danheeks/BartonFirtop/bartonfirtop/Step Down Converter.stp

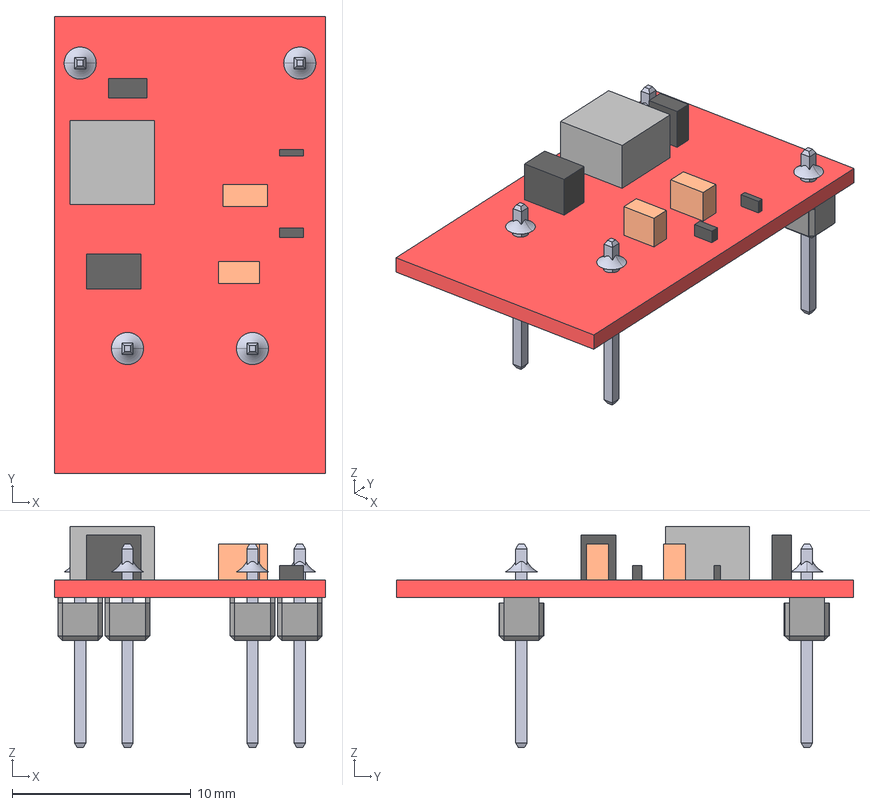
[picture p3: CAD file, 2025-02-03]
bartonfirtop/Step Down Converter.stp
15.2 x 25.6 x 12.4 mm
Design5
