danheeks/BartonFirtop/User Guide.docx

const char* ssid = "Paul's Phone";

const char* password = "Mani1234";

192.168.4.1
