danheeks/BartonFirtop/RD-077-03 _Rev.00.pdf

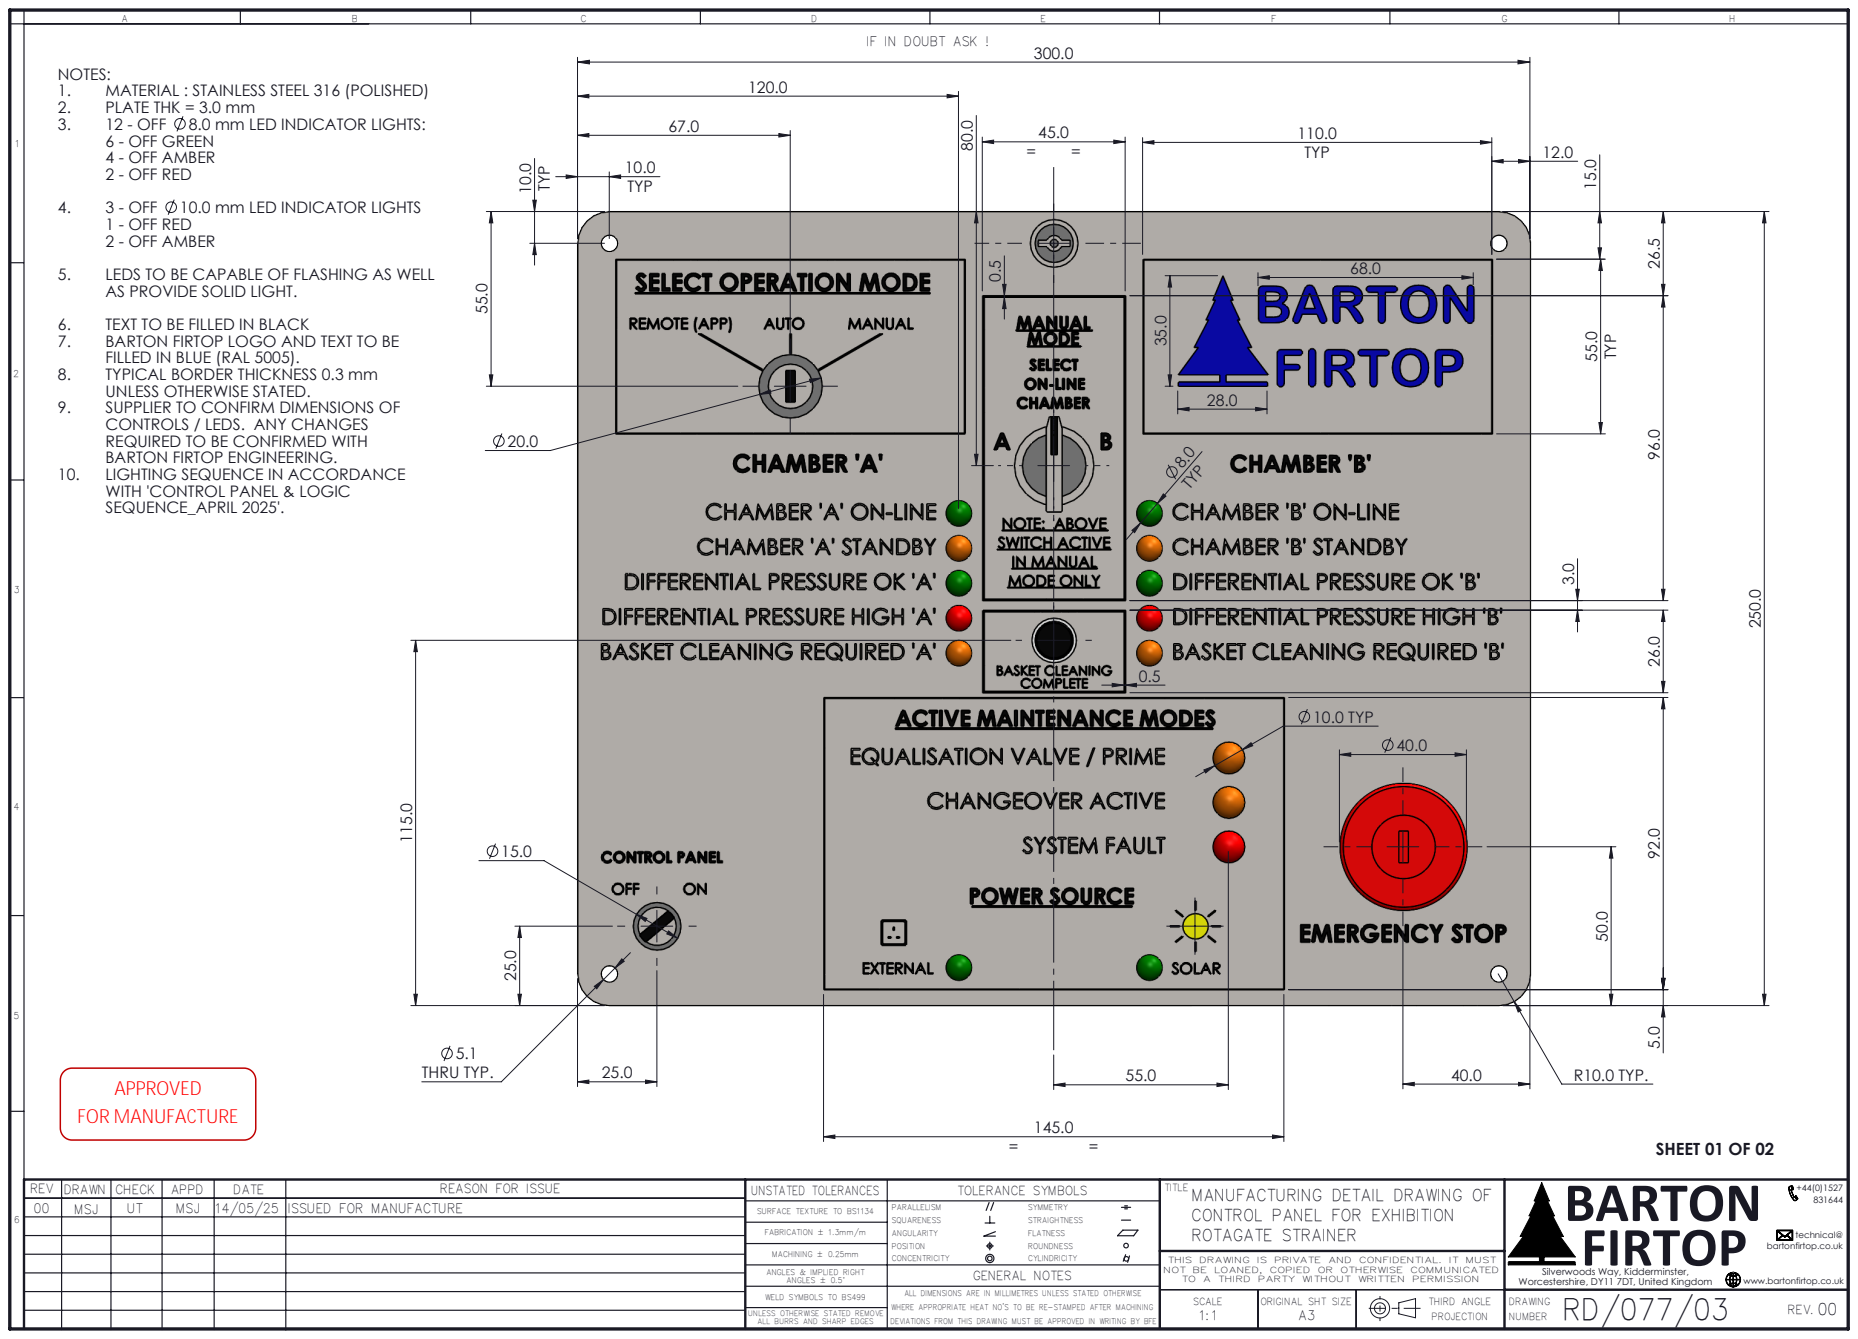
[picture p4: page 1]
Worcestershire, DY11 7DT, United Kingdom; www.bartonfirtop.co.uk; FIRTOP technical@; R10.0 TYP. 25.0; 10.0 TYP; THRU TYP.; SHEET 01 OF 02; REV DRAWN; DATE; SCALE; ORIGINAL SHT SIZE; THIRD ANGLE; TOLERANCE SYMBOLS; FABRICATION ± 1.3mm/m; UNSTATED TOLERANCES; ANGLES ± 0.5°; GENERAL NOTES; MSJ; MSJ 14/05/25

IF IN DOUBT ASK !

NOTES:
1. MATERIAL : STAINLESS STEEL 316 (POLISHED)
2. PLATE THK = 3.0 mm
3. 12 - OFF 8.0 mm LED INDICATOR LIGHTS:
6 - OFF GREEN
4 - OFF AMBER
2 - OFF RED
4. 3 - OFF 10.0 mm LED INDICATOR LIGHTS
1 - OFF RED
2 - OFF AMBER
5. LEDS TO BE CAPABLE OF FLASHING AS WELL
AS PROVIDE SOLID LIGHT.
6. TEXT TO BE FILLED IN BLACK
7. BARTON FIRTOP LOGO AND TEXT TO BE
FILLED IN BLUE (RAL 5005).
8. TYPICAL BORDER THICKNESS 0.3 mm
UNLESS OTHERWISE STATED.
9. SUPPLIER TO CONFIRM DIMENSIONS OF
CONTROLS / LEDS. ANY CHANGES
REQUIRED TO BE CONFIRMED WITH
BARTON FIRTOP ENGINEERING.
10. LIGHTING SEQUENCE IN ACCORDANCE
WITH 'CONTROL PANEL & LOGIC
SEQUENCE_APRIL 2025'.

REASON FOR ISSUE

TITLE
MANUFACTURING DETAIL DRAWING OF
CONTROL PANEL FOR EXHIBITION
ROTAGATE STRAINER

ISSUED FOR MANUFACTURE

SURFACE TEXTURE TO BS1134

bartonfirtop.co.uk

MACHINING ± 0.25mm
ANGLES & IMPLIED RIGHT

THIS DRAWING IS PRIVATE AND CONFIDENTIAL. IT MUST
NOT BE LOANED, COPIED OR OTHERWISE COMMUNICATED
TO A THIRD PARTY WITHOUT WRITTEN PERMISSION

Silverwoods Way, Kidderminster,

WELD SYMBOLS TO BS499
UNLESS OTHERWISE STATED REMOVE
ALL BURRS AND SHARP EDGES

ALL DIMENSIONS ARE IN MILLIMETRES UNLESS STATED OTHERWISE
WHERE APPROPRIATE HEAT NO'S TO BE RE-STAMPED AFTER MACHINING
DEVIATIONS FROM THIS DRAWING MUST BE APPROVED IN WRITING BY BFE

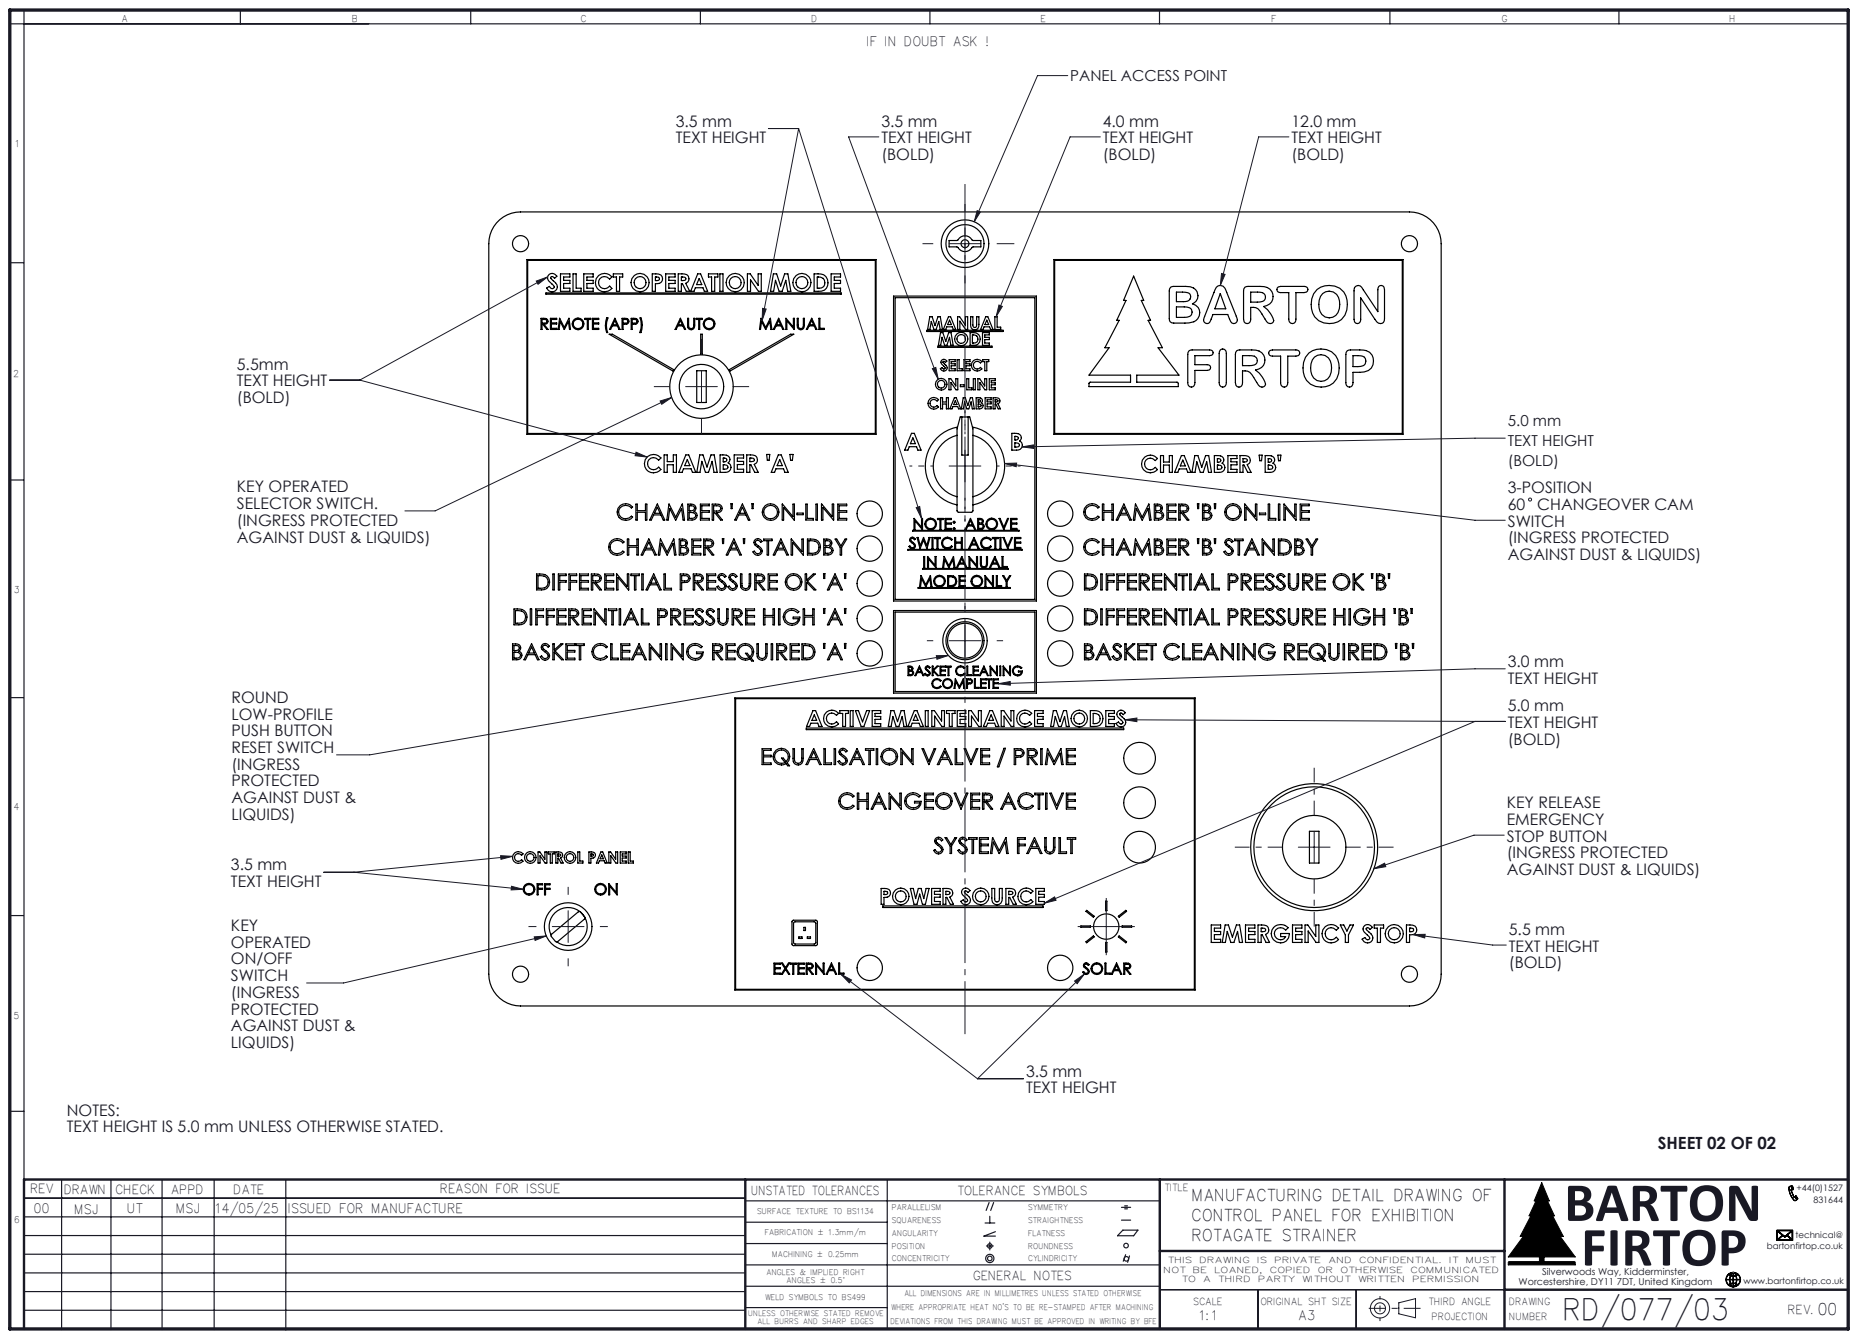
[picture p5: page 2]
Worcestershire, DY11 7DT, United Kingdom; www.bartonfirtop.co.uk; FIRTOP technical@; AGAINST DUST &; PUSH BUTTON RESET SWITCH; 3.5 mm TEXT HEIGHT; 5.5 mm TEXT HEIGHT; 12.0 mm TEXT HEIGHT; TEXT HEIGHT; 3.0 mm TEXT HEIGHT; 4.0 mm TEXT HEIGHT; 5.0 mm TEXT HEIGHT; SHEET 02 OF 02; REV DRAWN; DATE; SCALE; ORIGINAL SHT SIZE; THIRD ANGLE; TOLERANCE SYMBOLS; FABRICATION ± 1.3mm/m; UNSTATED TOLERANCES; ANGLES ± 0.5°; GENERAL NOTES; MSJ; MSJ 14/05/25

IF IN DOUBT ASK !

PANEL ACCESS POINT

TEXT HEIGHT
(BOLD)
3-POSITION
60 CHANGEOVER CAM
SWITCH
(INGRESS PROTECTED
AGAINST DUST & LIQUIDS)

KEY OPERATED
SELECTOR SWITCH.

KEY RELEASE
EMERGENCY
STOP BUTTON

NOTES:
TEXT HEIGHT IS 5.0 mm UNLESS OTHERWISE STATED.

REASON FOR ISSUE

TITLE
MANUFACTURING DETAIL DRAWING OF
CONTROL PANEL FOR EXHIBITION
ROTAGATE STRAINER

ISSUED FOR MANUFACTURE

SURFACE TEXTURE TO BS1134

bartonfirtop.co.uk

MACHINING ± 0.25mm
ANGLES & IMPLIED RIGHT

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

Silverwoods Way, Kidderminster,

WELD SYMBOLS TO BS499
UNLESS OTHERWISE STATED REMOVE
ALL BURRS AND SHARP EDGES

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
