danheeks/BartonFirtop/bartonfirtop/bartonfirtop.kicad_pcb

## KiCad design bartonfirtop/bartonfirtop.kicad_pcb (2025-03-18)

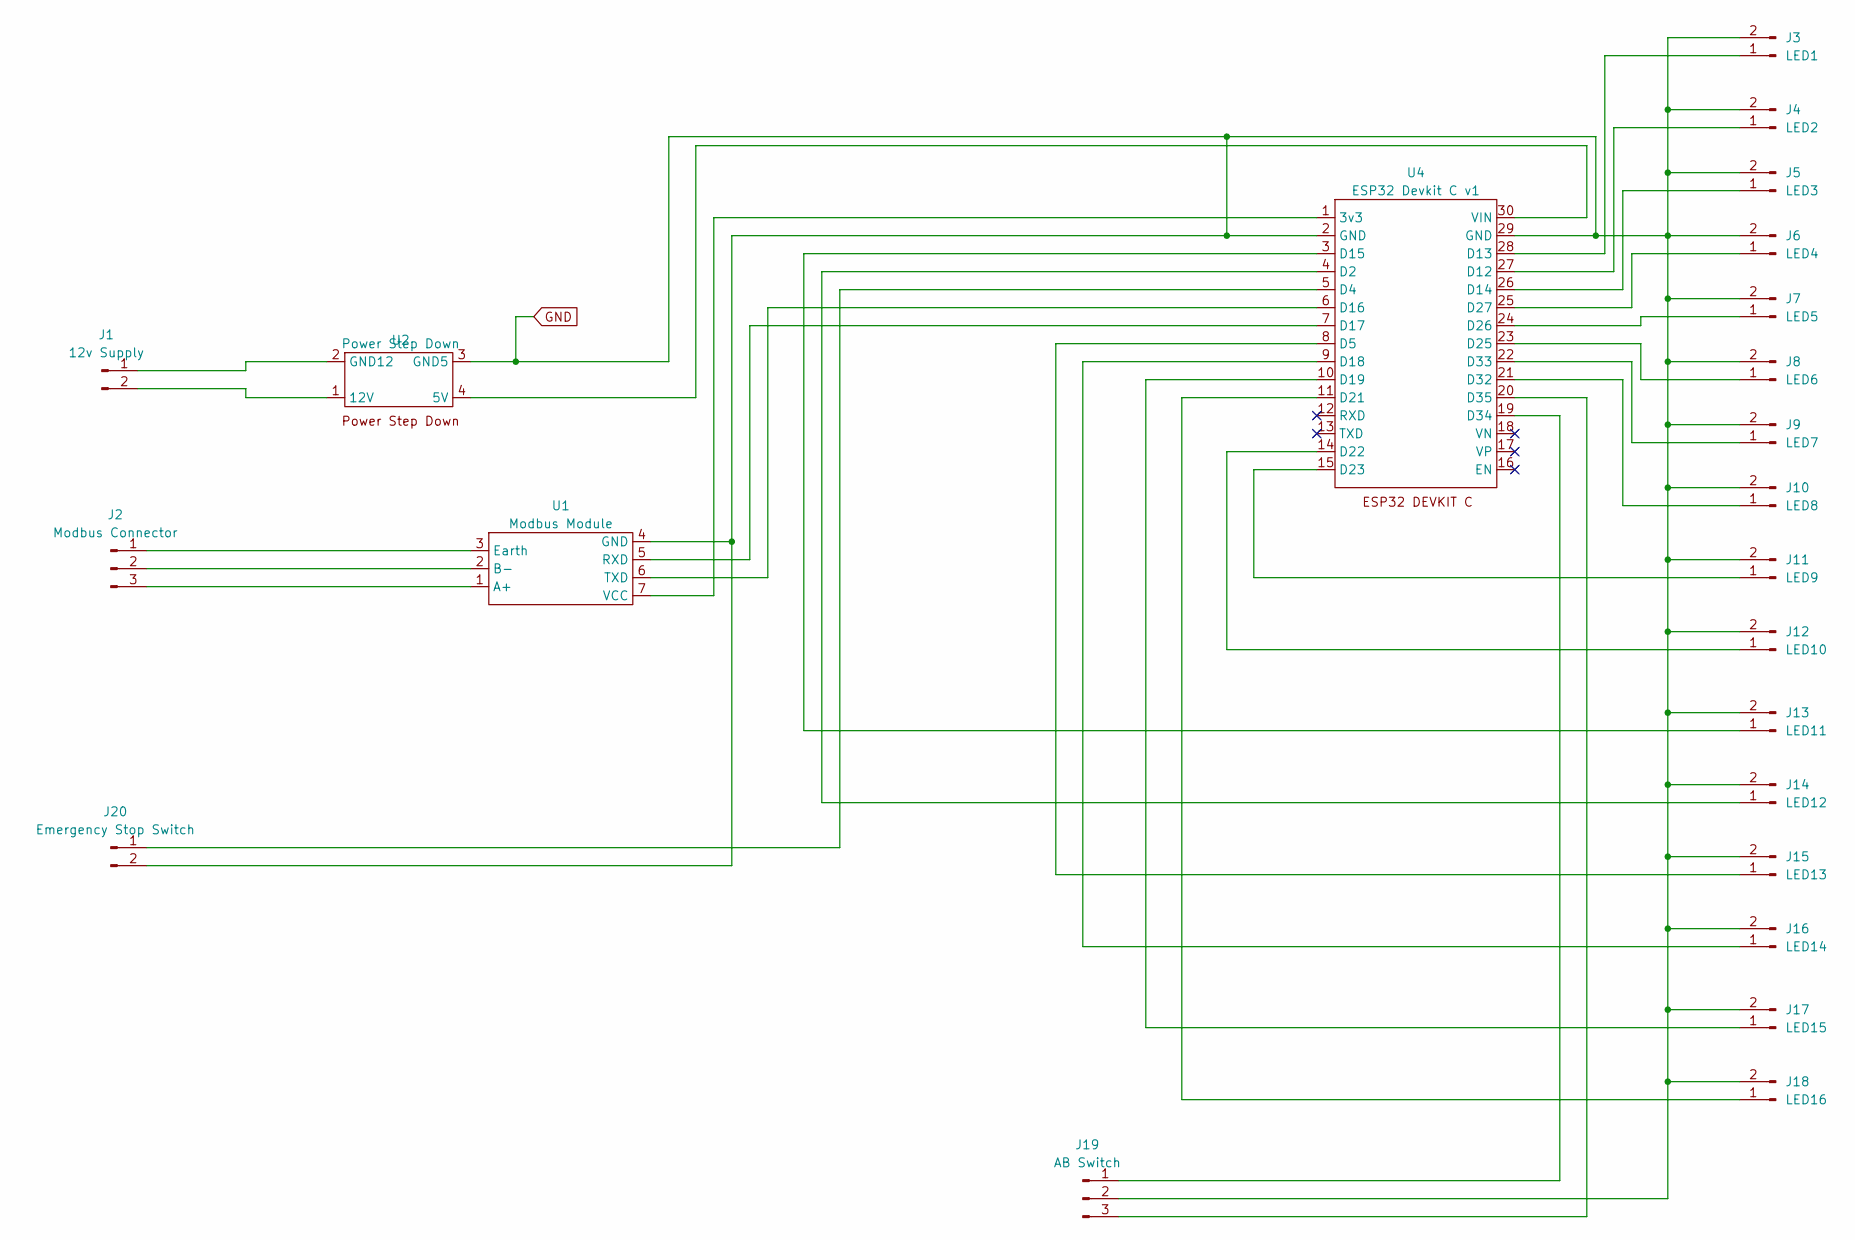
[picture p6: schematic bartonfirtop.kicad_sch]

Parts:
J1: 12v Supply; Molex_KK-254_AE-6410-02A_1x02_P2.54mm_Vertical
J2: Modbus Connector; Molex_KK-254_AE-6410-03A_1x03_P2.54mm_Vertical
J3: LED1; Molex_KK-254_AE-6410-02A_1x02_P2.54mm_Vertical
J4: LED2; Molex_KK-254_AE-6410-02A_1x02_P2.54mm_Vertical
J5: LED3; Molex_KK-254_AE-6410-02A_1x02_P2.54mm_Vertical
J6: LED4; Molex_KK-254_AE-6410-02A_1x02_P2.54mm_Vertical
J7: LED5; Molex_KK-254_AE-6410-02A_1x02_P2.54mm_Vertical
J8: LED6; Molex_KK-254_AE-6410-02A_1x02_P2.54mm_Vertical
J9: LED7; Molex_KK-254_AE-6410-02A_1x02_P2.54mm_Vertical
J10: LED8; Molex_KK-254_AE-6410-02A_1x02_P2.54mm_Vertical
J11: LED9; Molex_KK-254_AE-6410-02A_1x02_P2.54mm_Vertical
J12: LED10; Molex_KK-254_AE-6410-02A_1x02_P2.54mm_Vertical
J13: LED11; Molex_KK-254_AE-6410-02A_1x02_P2.54mm_Vertical
J14: LED12; Molex_KK-254_AE-6410-02A_1x02_P2.54mm_Vertical
J15: LED13; Molex_KK-254_AE-6410-02A_1x02_P2.54mm_Vertical
J16: LED14; Molex_KK-254_AE-6410-02A_1x02_P2.54mm_Vertical
J17: LED15; Molex_KK-254_AE-6410-02A_1x02_P2.54mm_Vertical
J18: LED16; Molex_KK-254_AE-6410-02A_1x02_P2.54mm_Vertical
J19: AB Switch; Molex_KK-254_AE-6410-03A_1x03_P2.54mm_Vertical
J20: Emergency Stop Switch; Molex_KK-254_AE-6410-02A_1x02_P2.54mm_Vertical
U1: Modbus Module
U2: Power Step Down; Step Down Buck Converter 24V - 5V
U4: ESP32 Devkit C v1; MODULE_ESP32_DEVKIT_V1

Connections:
GND: J3.2, J4.2, J5.2, J6.2, J7.2, J8.2, J9.2, J10.2, J11.2, J12.2, J13.2, J14.2, J15.2, J16.2, J17.2, J18.2, J19.2, J20.2, U1.4 (GND), U2.3 (GND5), U4.2 (GND), U4.29 (GND)
unnamed: J1.1, U2.2 (GND12)
unnamed: J1.2, U2.1 (12V)
unnamed: J2.1, U1.3 (Earth)
unnamed: J2.2, U1.2 (B-)
unnamed: J2.3, U1.1 (A+)
unnamed: J3.1, U4.28 (D13)
unnamed: J4.1, U4.27 (D12)
unnamed: J5.1, U4.26 (D14)
unnamed: J6.1, U4.25 (D27)
unnamed: J7.1, U4.24 (D26)
unnamed: J8.1, U4.23 (D25)
unnamed: J9.1, U4.22 (D33)
unnamed: J10.1, U4.21 (D32)
unnamed: J11.1, U4.15 (D23)
unnamed: J12.1, U4.14 (D22)
unnamed: J13.1, U4.3 (D15)
unnamed: J14.1, U4.4 (D2)
unnamed: J15.1, U4.8 (D5)
unnamed: J16.1, U4.9 (D18)
unnamed: J17.1, U4.10 (D19)
unnamed: J18.1, U4.11 (D21)
unnamed: J19.1, U4.19 (D34)
unnamed: J19.3, U4.20 (D35)
unnamed: J20.1, U4.5 (D4)
unnamed: U1.5 (RXD), U4.7 (D17)
unnamed: U1.6 (TXD), U4.6 (D16)
unnamed: U1.7 (VCC), U4.1 (3v3)
unnamed: U2.4 (5V), U4.30 (VIN)

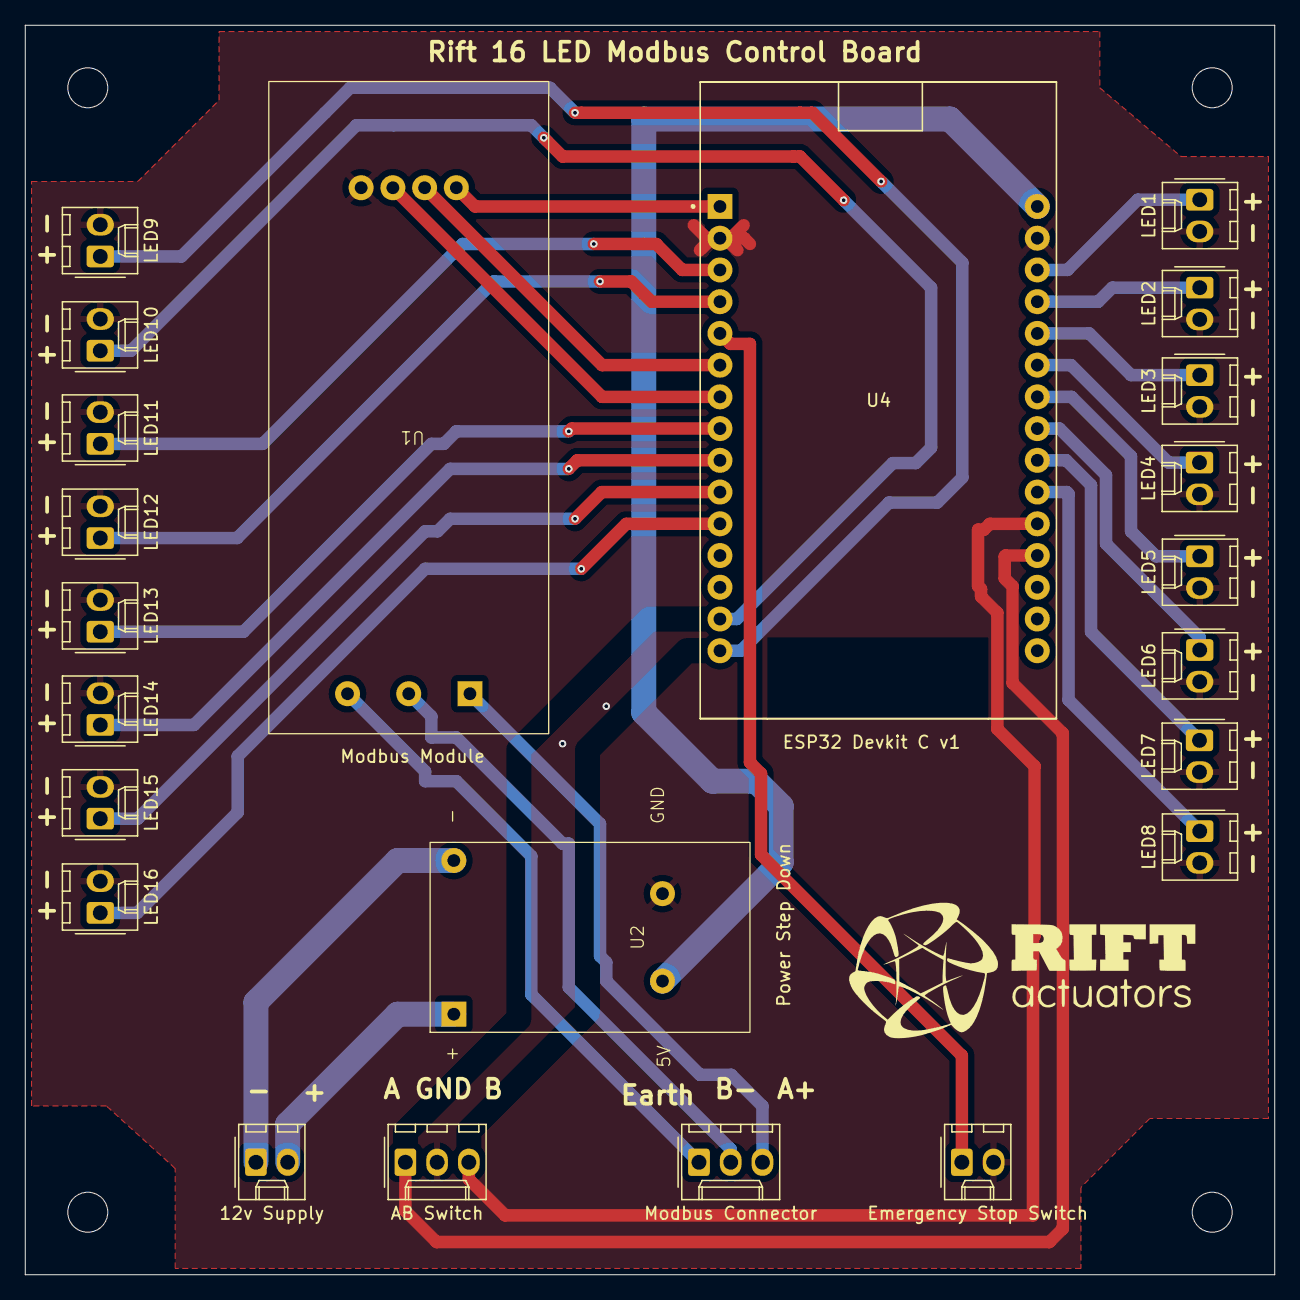
[picture p7: board bartonfirtop.kicad_pcb from above]

Board: 2 copper layers, 100.0 x 100.0 mm, 23 parts (0 on the bottom side), 29 nets.
