danheeks/BartonFirtop/(commit log)

2025-01-24 work on ESP32 Barton Firtop web page app
2025-01-25 open buttons messages received by ESP32
2025-01-28 work on schematic for board and on Arduino code
    [bartonfirtop.kicad_pcb, bartonfirtop.kicad_sch]
2025-01-28 I got my phone to control the actuator via ESP32 running web page
2025-01-29 added LED connectors
    [bartonfirtop.kicad_sch]
2025-01-30 added switches and more LEDs
    [bartonfirtop.kicad_sch]
2025-02-01 ordered 5 boards
    [Step Down Converter.stp, bartonfirtop.kicad_pcb, bartonfirtop.kicad_sch]
2025-03-07 I had + and - the wrong way for power connector
    [bartonfirtop.kicad_pcb]
2025-03-17 adding the 3D model for the ESP32
    [bartonfirtop.kicad_pcb]
2025-03-18 testing 16 LEDs on the control board
    [bartonfirtop.kicad_pcb, bartonfirtop.kicad_sch]
2025-03-18 I removed old arduino project to reduce confusion
2025-03-20 OK. I have all the basics working; Modbus, Wifi with web page, LEDs, SPIFFS. :) So now to get it to do a sequence that we want.
2025-03-20 Great! I have got LEDs lighting on the web page, the same as on the real control panel
2025-03-25 I got a sequence working
    [bartonfirtop.kicad_sch]
2025-05-20 schematic change
    [bartonfirtop.kicad_sch]
2025-05-26 added 3 way key switch
    [bartonfirtop.kicad_sch]
2025-06-24 I replaced the A and B buttons on the app with a 3 position slider. You can now switch the physical AB button quickly and it still works ok. When the actuator hits a torque limit, the system fault fl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
    [control_panel.ino]
